MayurWare/EDL-2022/README.md

# Electronic Design Lab (EDL)
## Department of Electrical Engineering, IIT Bombay
### Autumn 2021
