MayurWare/EDL-2022/JJ-9-1_EE344_Lab_Report_Feb15.pdf

EE344

## Electronic Design Lab Lab Report TUE-JJ-9-1

Mayur Ware, 19D070070
Siddhant Shingade, 19D070057 Rushikesh Metkar, 19D070034

February 15, 2022
Selection of Temperature Sensor :
The most important work to do for us in this week was to choose the sensor. The important factors to consider while choosing the sensor were :
- The Dark Current
- Output range (this should be well above the input bias voltage of the Op-amp to avoid the errors)
- Temperature range
- Dimensions of the sensor
- Low noise voltage
So, after looking at various options, we shortlisted two sensors :
1) TS305-11C55
2) ISB-TS45H
We will select and order the sensor after looking at the price and availability. We will inform the same with the WEL TAs and Prof. J. John.
Selection of Amplifying Op-amp :
As discussed before, selection of Op-amp is very important as we have to deal with the very low output voltages of the sensor. Output of sensor typically ranges in few mAmps, so the input offset voltage of the Op-amp should be very low compared to this range. The Op-amp should have low input bias current, low voltage and currents drifts and also low noise voltage. We have shortlisted some Op-amps matching the specifications. Luckily, we got an Op-amp OP07CP in the WEL only.

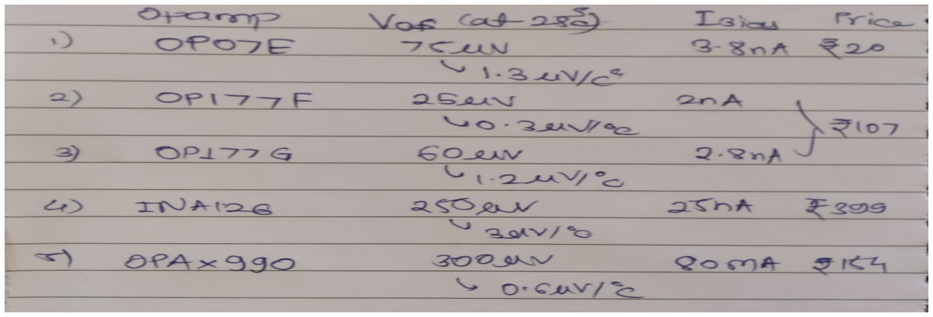
[picture p1: figure]

Photodiode based Temperature Sensor :
As instructed by prof. J. John in the previous lab, we built a photodiode based temperature sensor circuit to observe the output and also verified the working of OP07CP Op-amp.

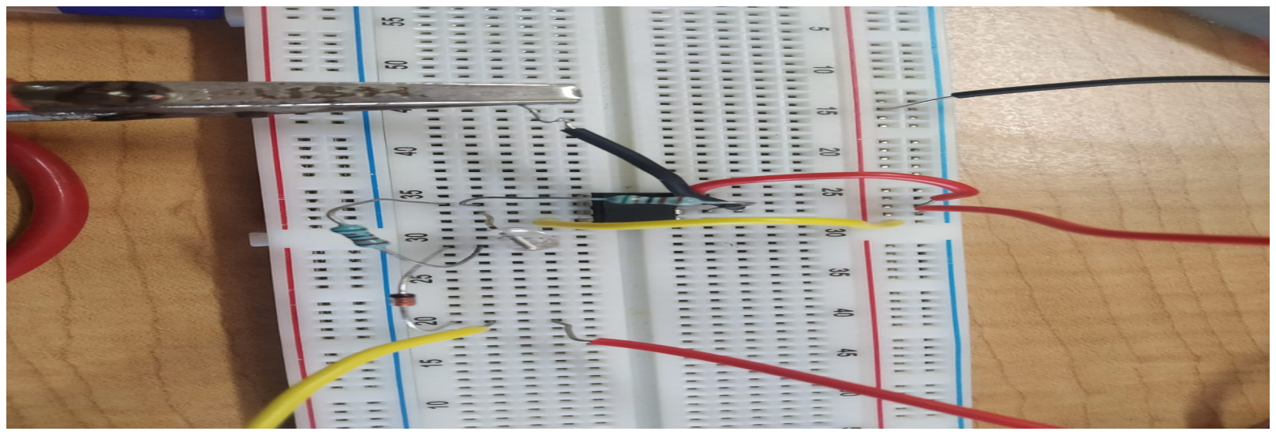
[picture p2: figure]

The experiment was successful as we clearly noticed the variation in output by varying the conditions. We plan to replace the Photodiode by the sensor for our project as photodiode has poor working abilities with temperature variations.
