MayurWare/EDL-2022/JJ-9-1_EE344_Lab_Report_Mar14.pdf

EE344

# Electronic Design Lab Lab Report TUE-JJ-9-1

Mayur Ware, 19D070070
Siddhant Shingade, 19D070057 Rushikesh Metkar, 19D070034

### March 14, 2022

Sensor Circuit and Lens:
Today we used our lens for infrared temperature sensor for focusing radiations from the object/surface onto our temperature sensor.We also worked on the circuit and tested it’s correctness.
We got the voltage output of the circuit for skin contact in the desired range. Also, we used hot soldering iron to study the variation of output for such high temperatures.After bringing the soldering iron well within the range of the temperature sensor, we indeed recorded an increase in voltage output. For skin contact we got output voltage in the range of 50 mV and for the hot soldering iron we got an output voltage in the range of 450 mV. The pictures below show our work.

1

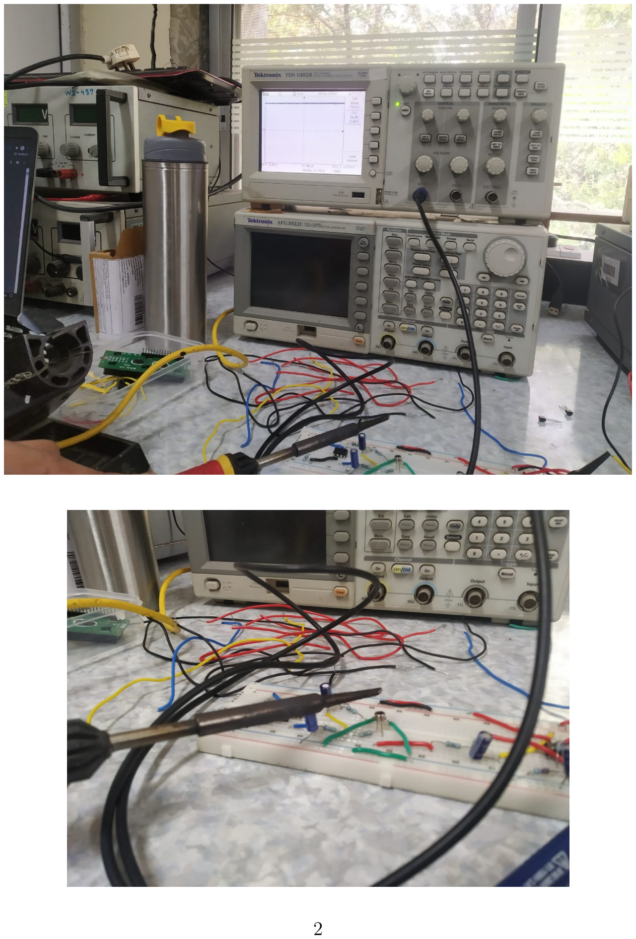
[picture p8: page 2]

2

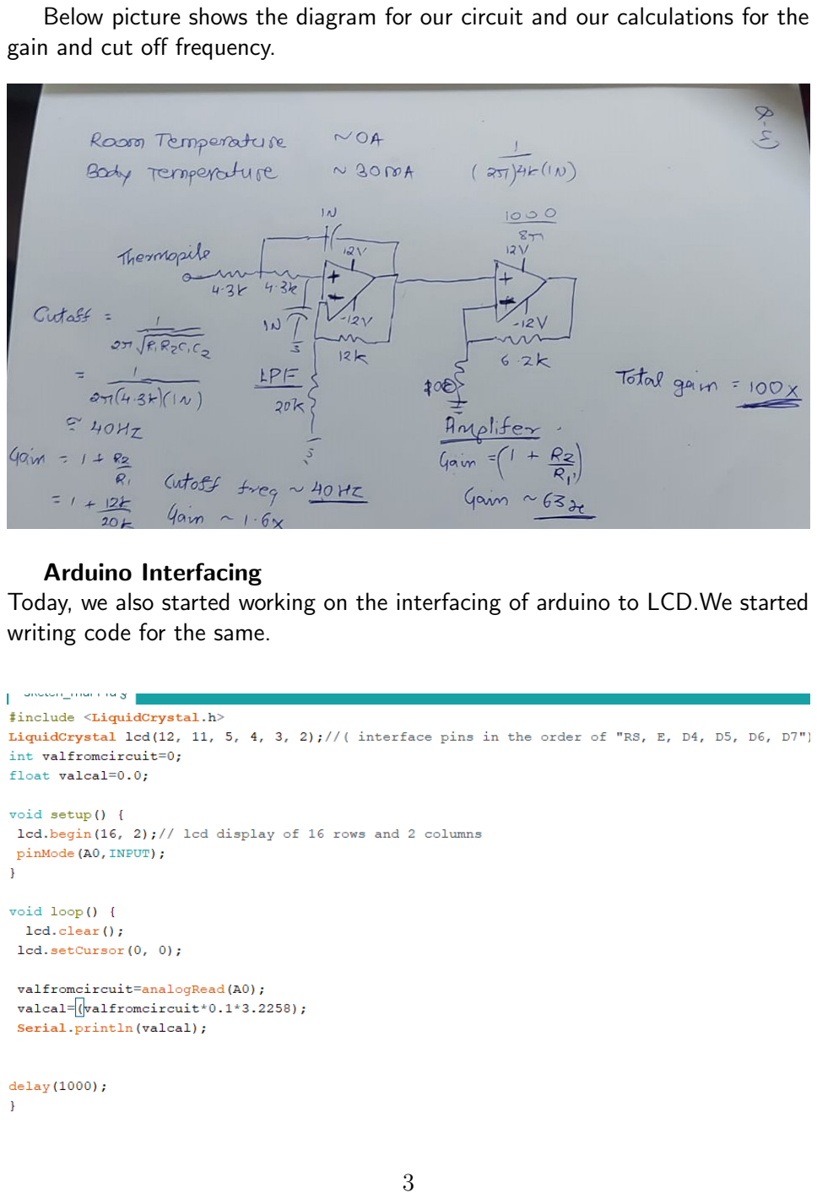
[picture p9: page 3]

Below picture shows the diagram for our circuit and our calculations for the gain and cut off frequency.

Arduino Interfacing
Today, we also started working on the interfacing of arduino to LCD.We started writing code for the same.

3
