MayurWare/EDL-2022/JJ-9-1_EE344_Lab_Report_Mar17_Voluntary_Session.pdf

EE344

## Electronic Design Lab

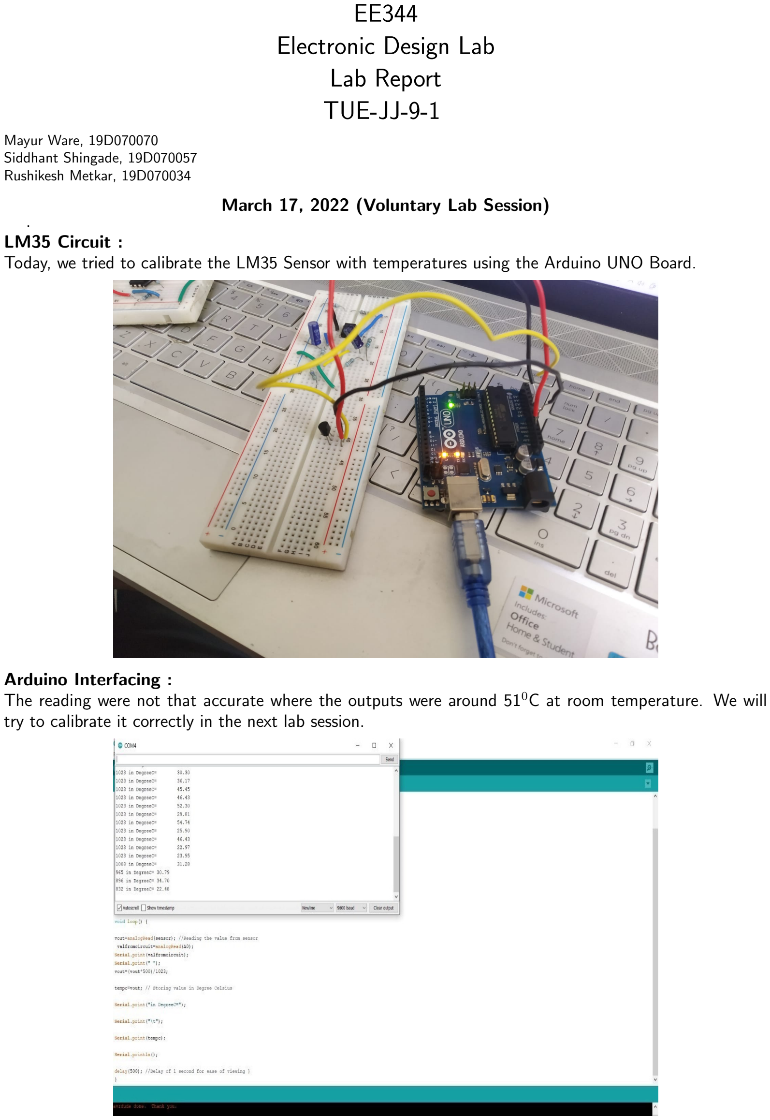
[picture p10: page 1]

## Lab Report TUE-JJ-9-1

Mayur Ware, 19D070070
Siddhant Shingade, 19D070057 Rushikesh Metkar, 19D070034

March 17, 2022 (Voluntary Lab Session) .
LM35 Circuit :
Today, we tried to calibrate the LM35 Sensor with temperatures using the Arduino UNO Board.

Arduino Interfacing :
The reading were not that accurate where the outputs were around 51⁰C at room temperature. We will try to calibrate it correctly in the next lab session.

Sensor Calibration :
We tried to calibrate the sensor using the Arduino Board but readings were coming wrong. We will try to fix the issue in the next lab.

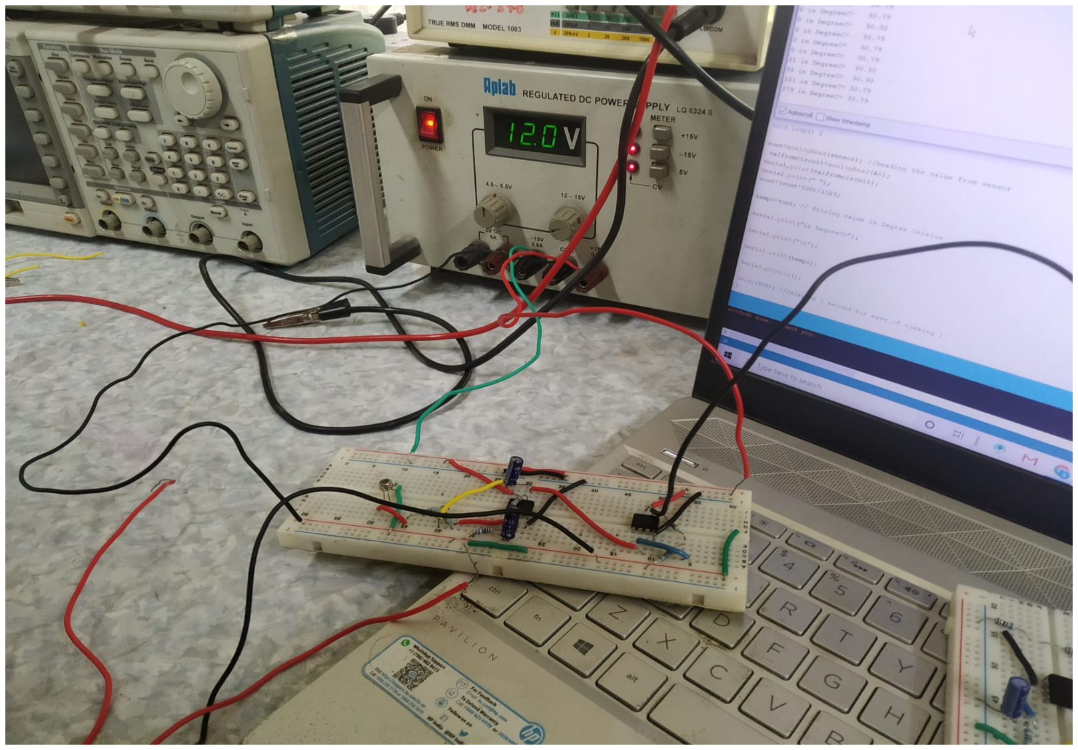
[picture p11: figure]
