MayurWare/EDL-2022/JJ-9-1_EE344_Lab_Report_Mar21.pdf

EE344

## Electronic Design Lab

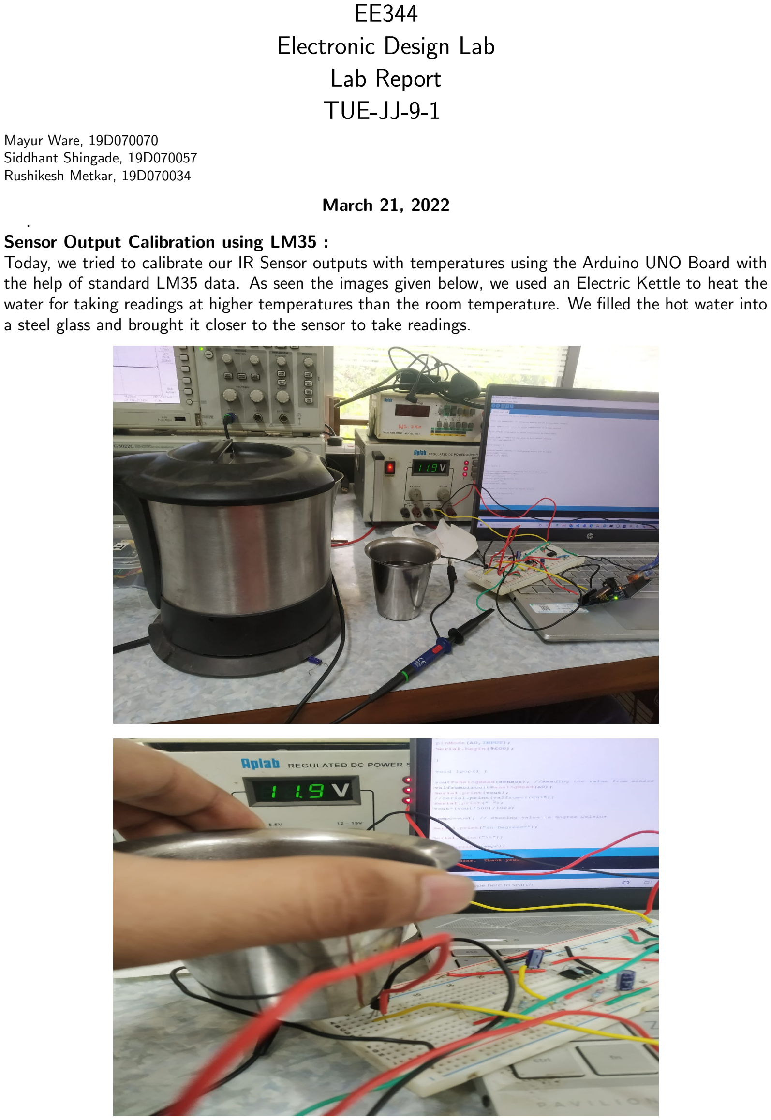
[picture p12: page 1]

## Lab Report TUE-JJ-9-1

Mayur Ware, 19D070070
Siddhant Shingade, 19D070057 Rushikesh Metkar, 19D070034

March 21, 2022
Sensor Output Calibration using LM35 :
Today, we tried to calibrate our IR Sensor outputs with temperatures using the Arduino UNO Board with the help of standard LM35 data. As seen the images given below, we used an Electric Kettle to heat the water for taking readings at higher temperatures than the room temperature. We filled the hot water into a steel glass and brought it closer to the sensor to take readings.

Arduino Interfacing of Sensor Outputs :
Then we tried to calibrate the sensor output with the standard LM35 readings. The outputs was fairly matches but some errors were occurring. We will try to fix these errors and finalize the circuit for PCB fabrication in the next lab.

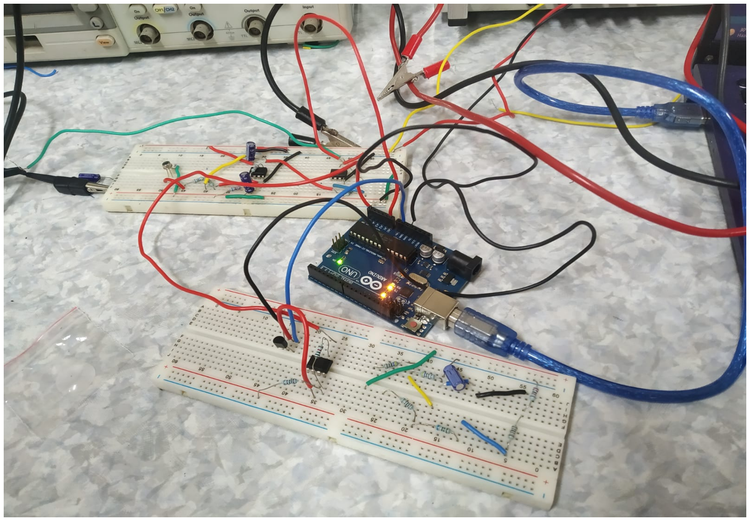
[picture p13: figure]

■
