MayurWare/EDL-2022/TUE-JJ-9-1.pdf

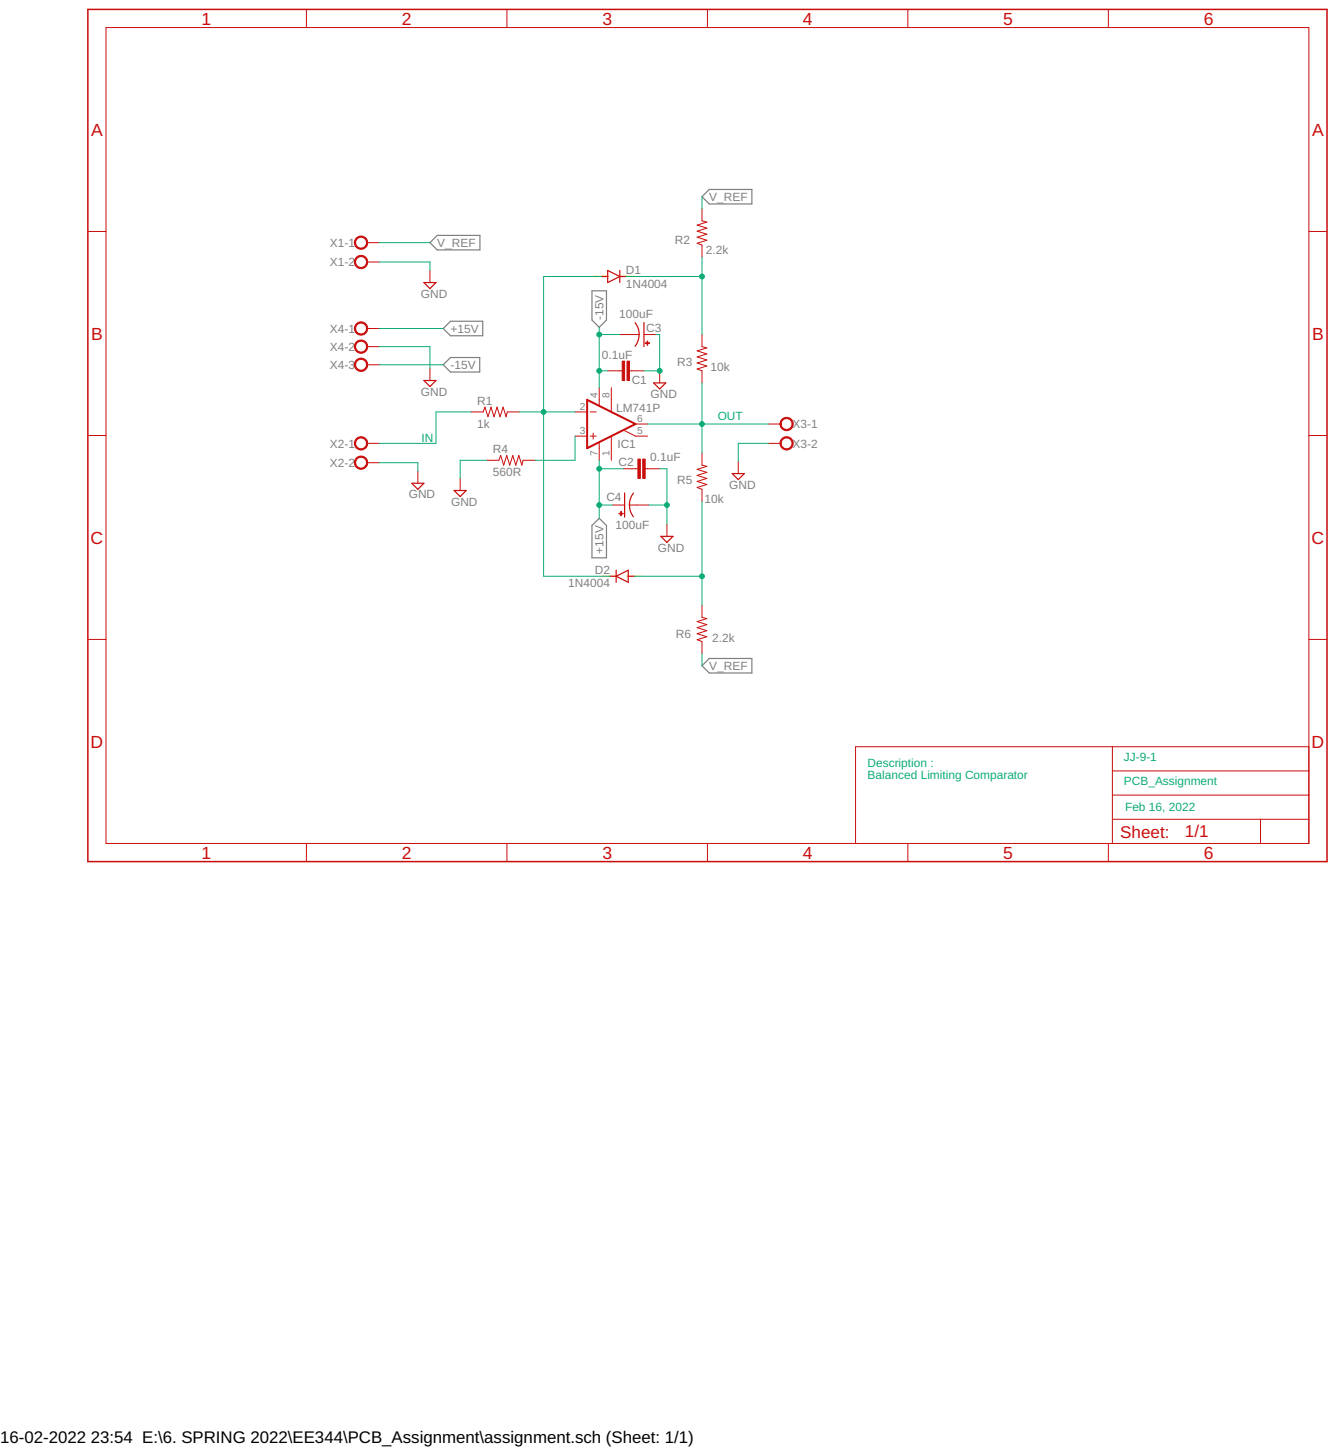
[picture p17: page 1]

Description : Balanced Limiting Comparator

16-02-2022 23:54 E:\6. SPRING 2022\EE344\PCB_Assignment\assignment.sch (Sheet: 1/1)
