MayurWare/EDL-2022/TUE-JJ-9-1_Board.pdf

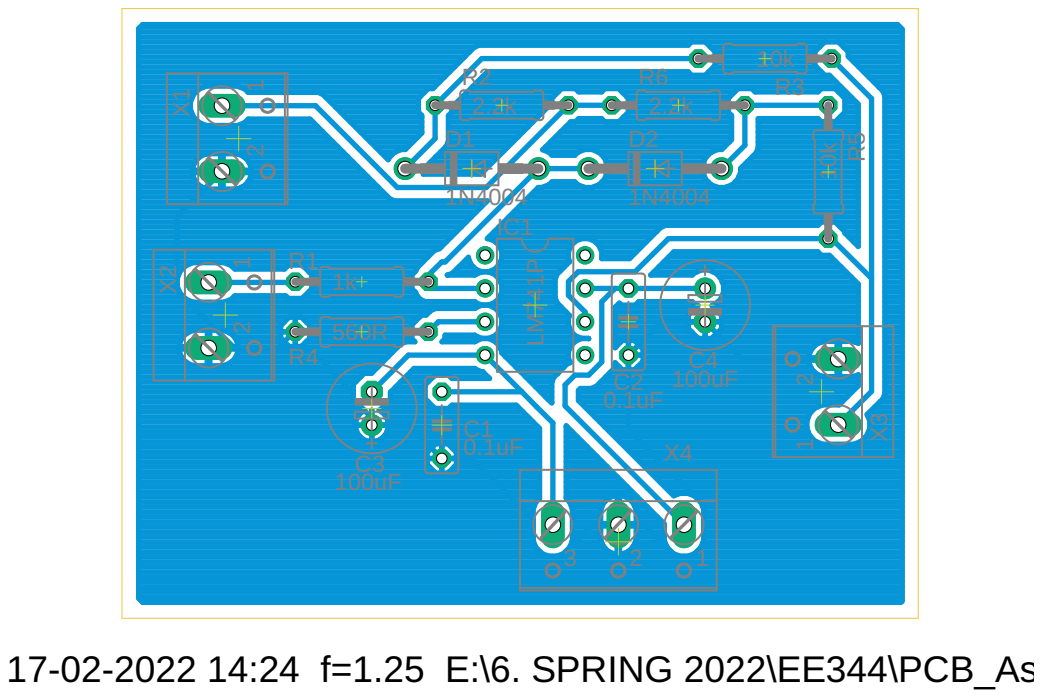
[picture p18: page 1]
