MayurWare/EDL-2022/TUE-JJ-9-1.brd

## EAGLE design TUE-JJ-9-1.brd (2022-05-08)

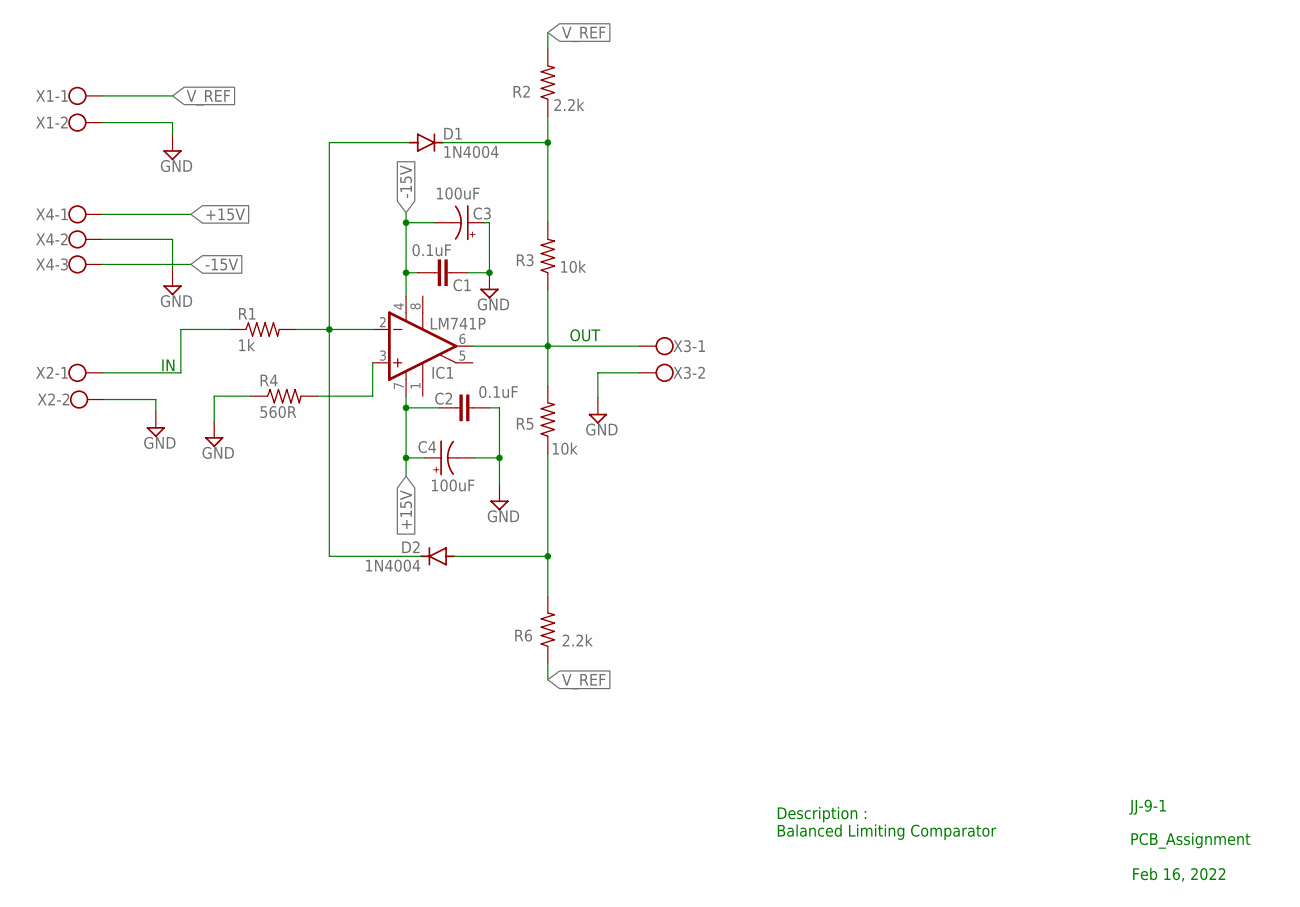
[picture p19: schematic TUE-JJ-9-1.sch]

Parts:
C1, C2: 0.1uF; C050-025X075
C3, C4: 100uF; E2,5-7
D1, D2: 1N4004; DO41-10
IC1: LM741P; DIL08
R1: 1k; 0207/10
R2, R6: 2.2k; 0207/10
R3, R5: 10k; 0207/10
R4: 560R; 0207/10
X1, X2, X3: W237-102
X4: W237-103

Connections:
+15V: C2.1, C4.+, IC1.7 (V+), X4.1
-15V: C1.1, C3.-, IC1.4 (V-), X4.3
GND: C1.2, C2.2, C3.+, C4.-, R4.1, X1.2, X2.2, X3.2, X4.2
unnamed: IC1.3 (+IN), R4.2
unnamed: D1.A, D2.C, IC1.2 (-IN), R1.2
unnamed: D1.C, R2.1, R3.2
unnamed: IC1.6 (OUT), R3.1, R5.2, X3.1
unnamed: D2.A, R5.1, R6.2
unnamed: R1.1, X2.1
V_REF: R2.2, R6.1, X1.1

Notes on the sheet:
OUT
JJ-9-1
PCB_Assignment
Feb 16, 2022
Description : Balanced Limiting Comparator

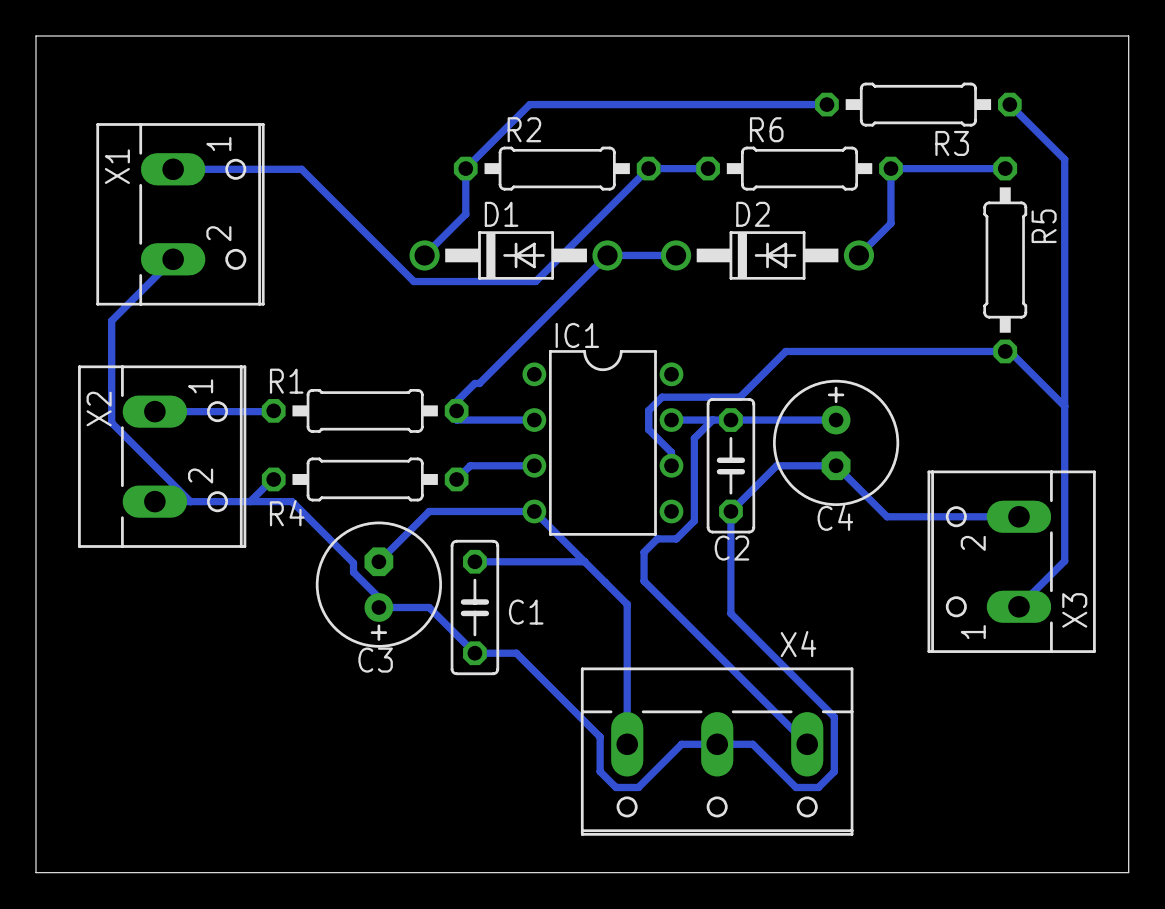
[picture p20: board TUE-JJ-9-1.brd from above]

Board: 2 copper layers, 60.7 x 46.5 mm, 17 parts (0 on the bottom side), 10 nets.
